bap10357/oct-pressure-device/pressure_encoder_documentation/figures/DRV8825_pinout.png

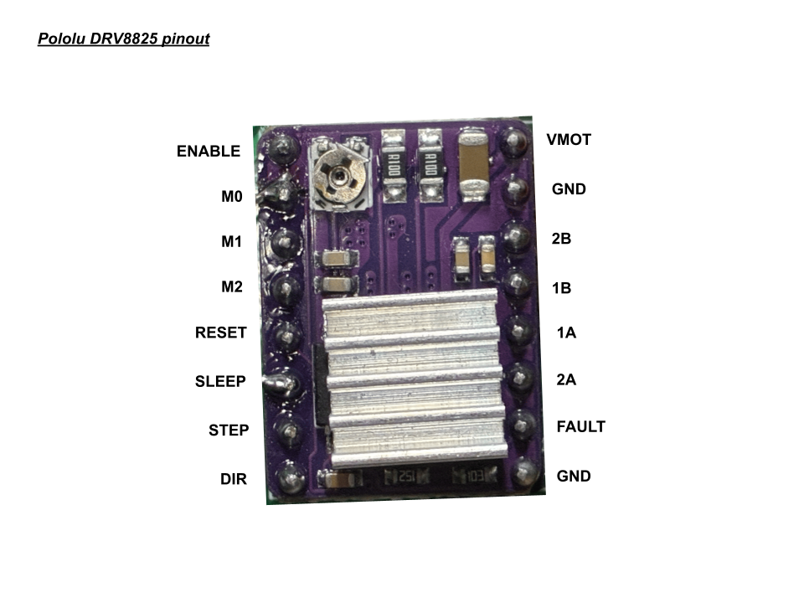
pressure_encoder_documentation/figures/DRV8825_pinout.png
