bap10357/oct-pressure-device/pressure_encoder_documentation/figures/completed_trial.png

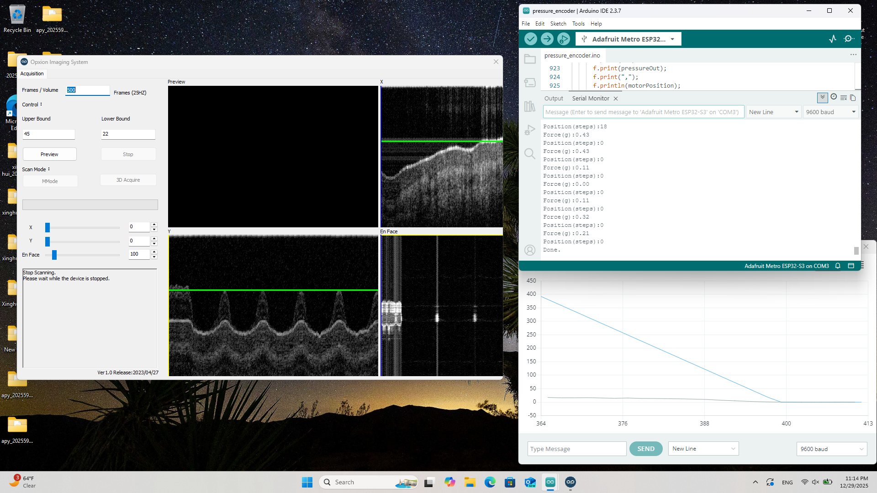
pressure_encoder_documentation/figures/completed_trial.png
