bap10357/oct-pressure-device/README.md

THIS REPOSITORY HAS BEEN MOVED TO CODEBERG --> https://codeberg.org/brpe/au-oct-pressure-device/

The source code, schematics, and documentation for the optical coherence tomography air pressure control device for the Asia University Biodesign Lab (https://pweb.asia.edu.tw/cwlung/).
