bap10357/oct-pressure-device/pressure_encoder_documentation/youtube.md

## How to use OCT pressure device
https://www.youtube.com/watch?v=-lr18eq3X60
