bap10357/oct-pressure-device/pressure_encoder_board/3D_view.png

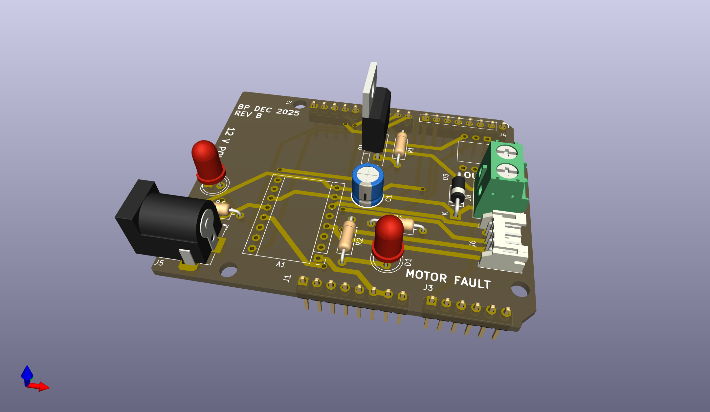
pressure_encoder_board/3D_view.png
