bap10357/oct-pressure-device/pressure_encoder_documentation/figures/airflow_diagram.png

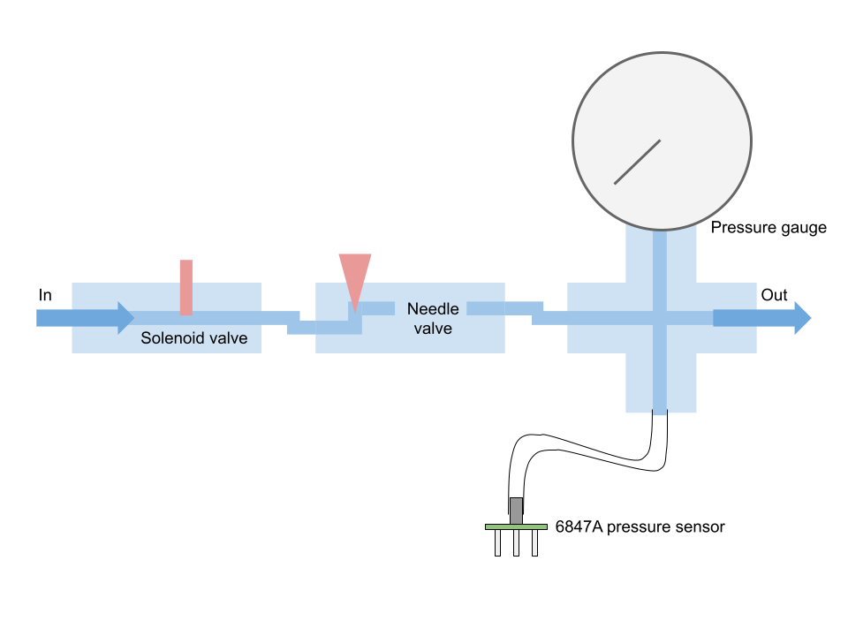
pressure_encoder_documentation/figures/airflow_diagram.png
