bap10357/oct-pressure-device/pressure_encoder_documentation/figures/connect_laser.png

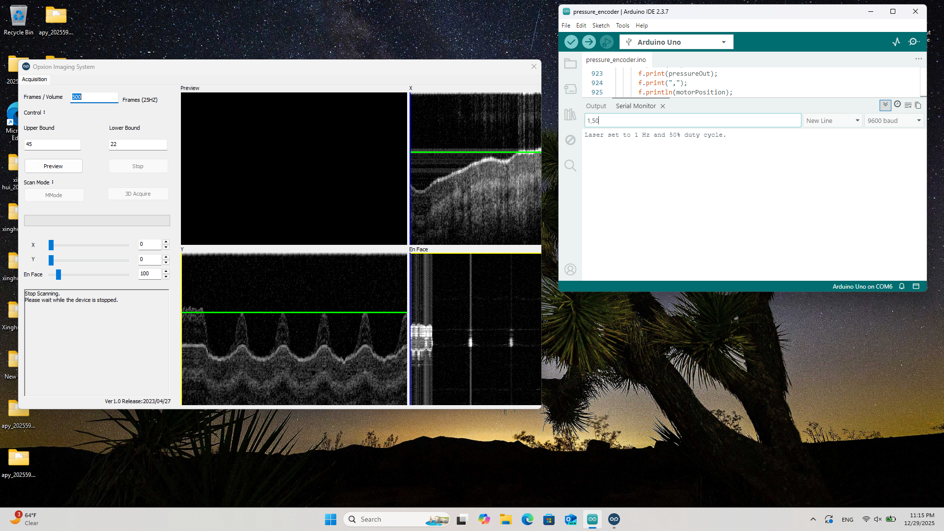
pressure_encoder_documentation/figures/connect_laser.png
