bap10357/oct-pressure-device/pressure_encoder_documentation/figures/processing_done.png

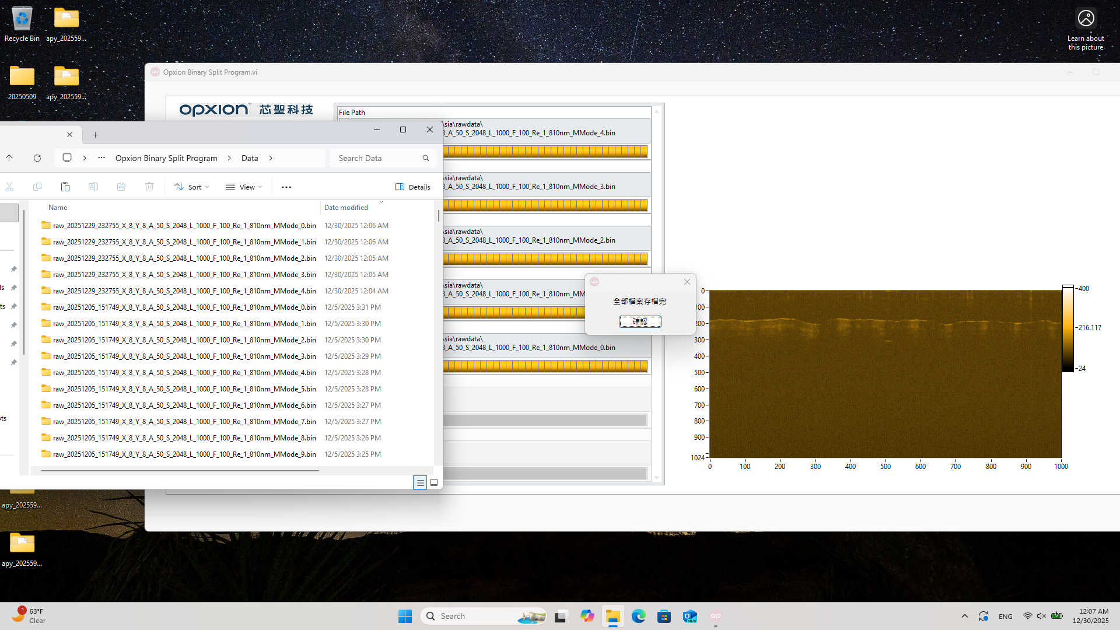
pressure_encoder_documentation/figures/processing_done.png
