bap10357/oct-pressure-device/pressure_encoder_board/pressure_encoder_board.kicad_pcb

## KiCad design pressure_encoder_board/pressure_encoder_board.kicad_pcb (2025-12-28)

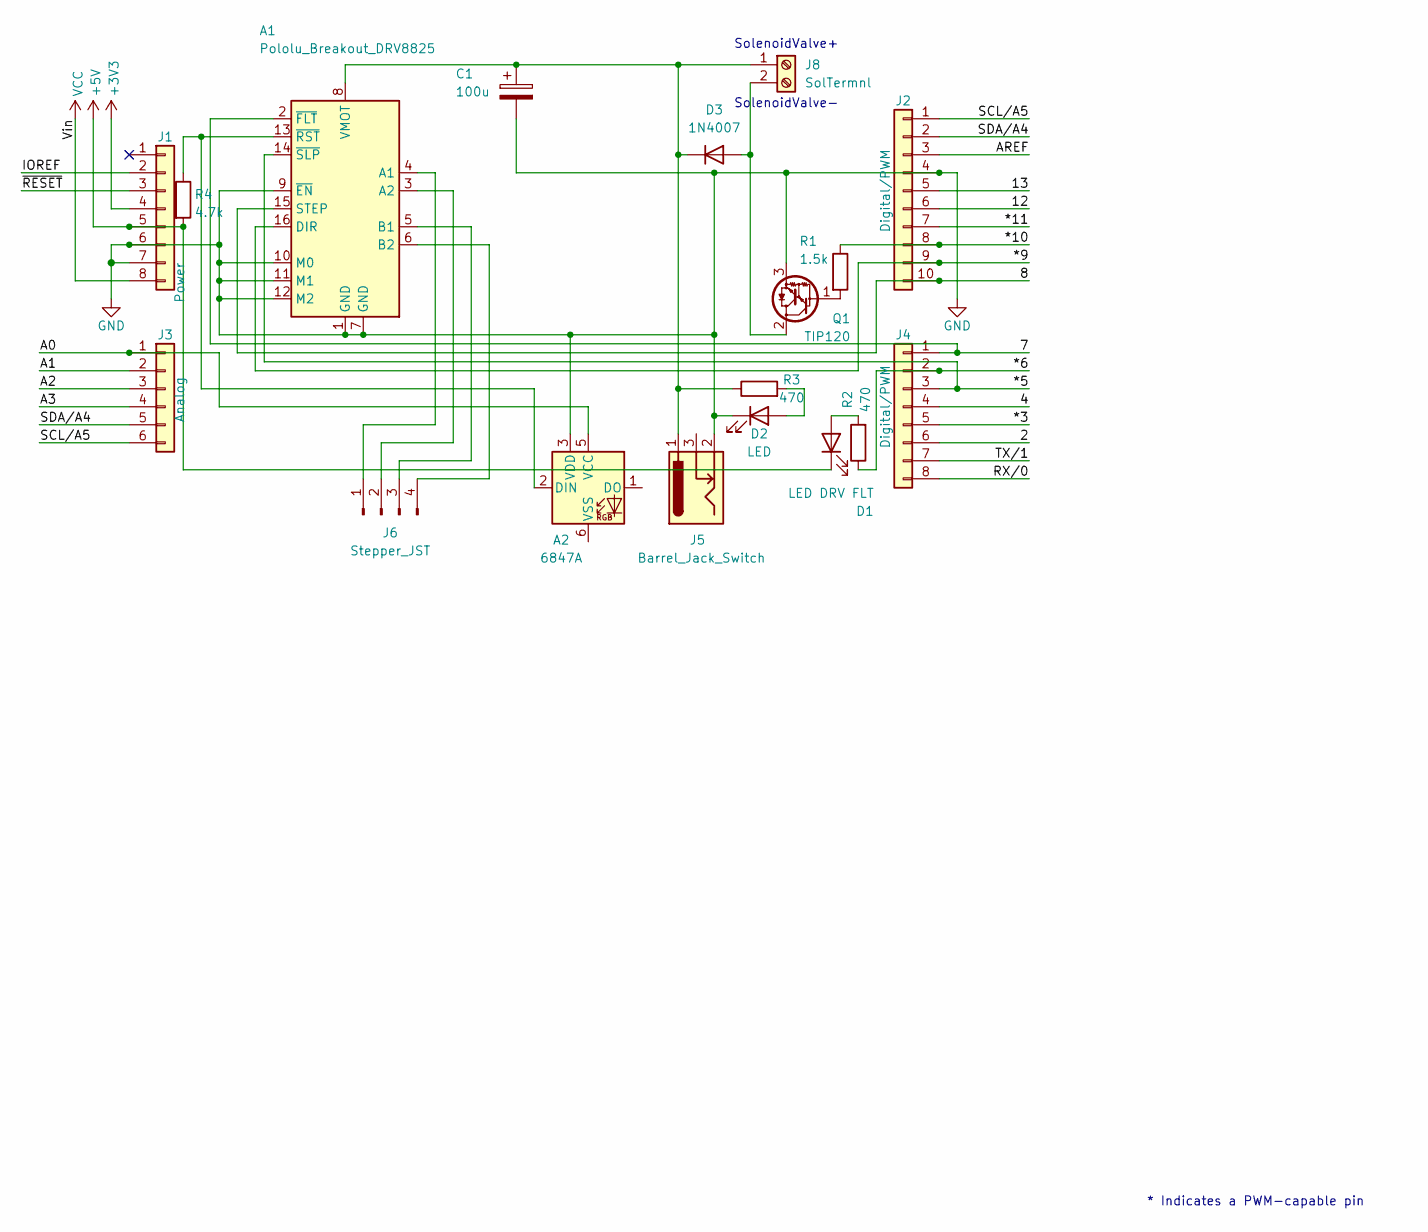
[picture p70: schematic pressure_encoder_board.kicad_sch, Arduino Hat for Pressure Controller]

Parts:
A1: Pololu_Breakout_DRV8825; Pololu_Breakout-16_15.2x20.3mm
A2: 6847A; DIP-6_W10.16mm
C1: 100u; CP_Radial_D6.3mm_P2.50mm
D1: LED DRV FLT; LED_D5.0mm
D2: LED; LED_D5.0mm
D3: 1N4007; D_DO-41_SOD81_P10.16mm_Horizontal
J1: Power; PinHeader_1x08_P2.54mm_Vertical
J2: Digital/PWM; PinHeader_1x10_P2.54mm_Vertical
J3: Analog; PinHeader_1x06_P2.54mm_Vertical
J4: Digital/PWM; PinHeader_1x08_P2.54mm_Vertical_Flipped_Trimmed
J5: Barrel_Jack_Switch; BarrelJack_Horizontal_Trimmed
J6: Stepper_JST; JST_PH_S4B-PH-K_1x04_P2.00mm_Horizontal
J8: SolTermnl; TerminalBlock_Phoenix_PT-1,5-2-5.0-H_1x02_P5.00mm_Horizontal
Q1: TIP120; TO-220-3_Vertical
R1: 1.5k; R_Axial_DIN0207_L6.3mm_D2.5mm_P10.16mm_Horizontal
R2, R3: 470; R_Axial_DIN0207_L6.3mm_D2.5mm_P10.16mm_Horizontal
R4: 4.7k; R_Axial_DIN0207_L6.3mm_D2.5mm_P10.16mm_Horizontal

Connections:
+3V3: J1.4
+5V: D1.1 (K), J1.5, R4.2
/2: J4.6
/4: J4.4
/7: A1.2 (~FLT), J4.1
/8: A1.15 (STEP), J2.10
/12: J2.6
/13: J2.5
/*3: J4.5
/*5: A1.14 (~SLP), J4.3
/*6: J4.2, R2.1
/*9: A1.16 (DIR), J2.9
/*10: J2.8, R1.1
/*11: J2.7
/A0: A2.5 (VCC), J3.1
/A1: J3.2
/A2: J3.3
/A3: J3.4
/AREF: J2.3
/IOREF: J1.2
/RX/0: J4.8
/SCL/A5: J2.1, J3.6
/SDA/A4: J2.2, J3.5
/TX/1: J4.7
/~RESET: J1.3
GND: A1.1 (GND), A1.7 (GND), A1.9 (~EN), A1.10 (M0), A1.11 (M1), A1.12 (M2), A2.3 (VDD), C1.2, D2.1 (K), J1.6, J1.7, J2.4, J5.2, Q1.3 (E)
unnamed: A1.4 (A1), J6.1
unnamed: A1.3 (A2), J6.2
unnamed: A1.5 (B1), J6.3
unnamed: A1.6 (B2), J6.4
unnamed: A1.8 (VMOT), C1.1, D3.1 (K), J5.1, J8.1, R3.1
unnamed: A1.13 (~RST), A2.2 (DIN), R4.1
unnamed: D1.2 (A), R2.2
unnamed: D2.2 (A), R3.2
unnamed: D3.2 (A), J8.2, Q1.2 (C)
unnamed: Q1.1 (B), R1.2
VCC: J1.8

Notes on the sheet:
SolenoidValve-
* Indicates a PWM-capable pin
SolenoidValve+

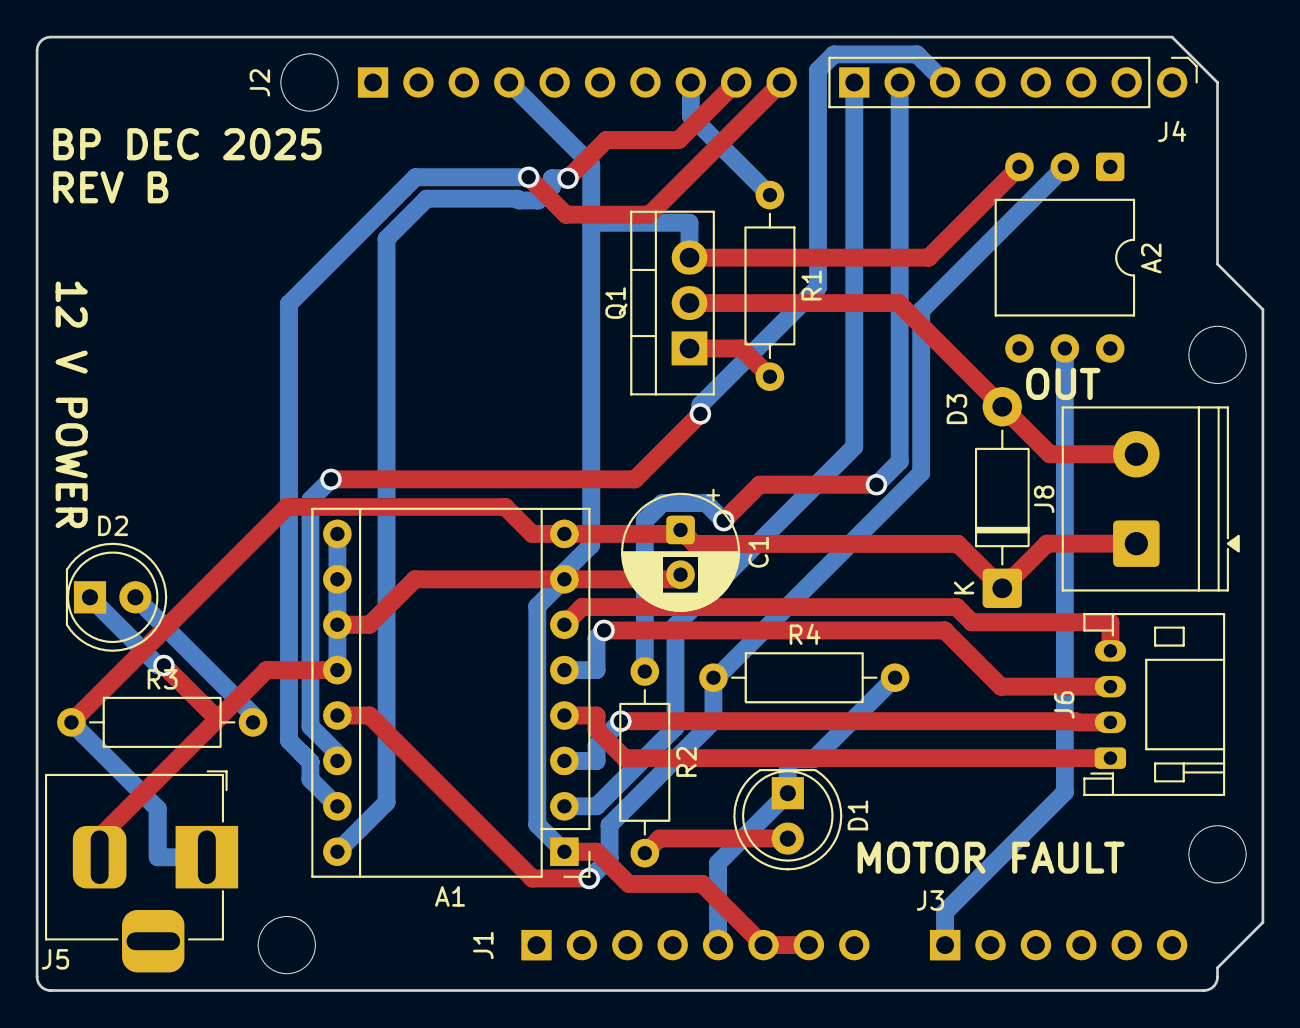
[picture p71: board pressure_encoder_board.kicad_pcb from above]

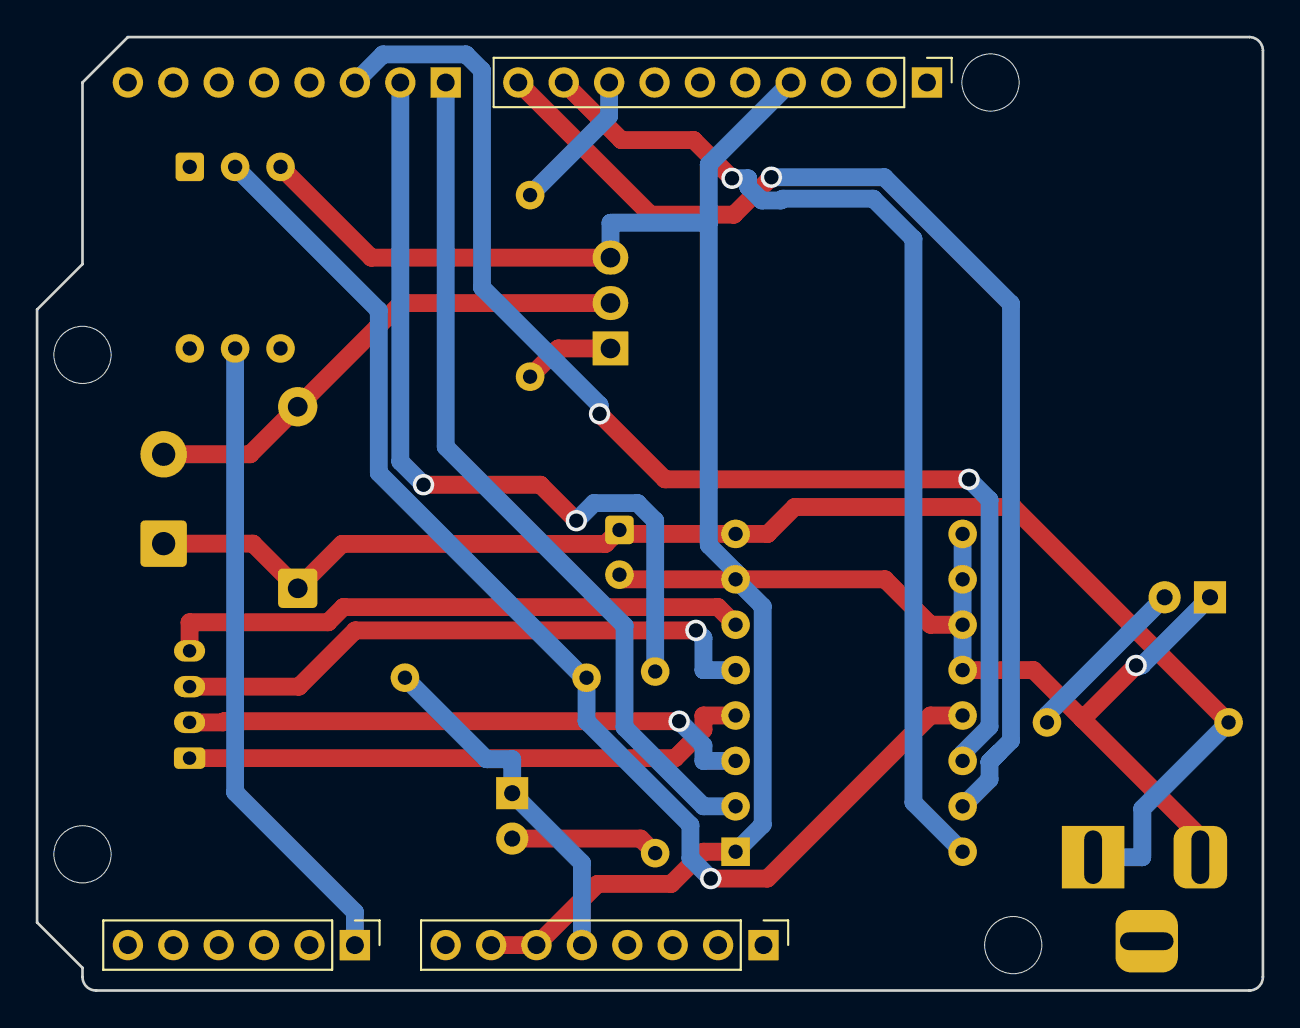
[picture p72: board pressure_encoder_board.kicad_pcb from below]

Board: 2 copper layers, 68.6 x 53.3 mm, 22 parts (4 on the bottom side), 21 nets.

Other parts of the board:
MH1, MH2, MH3, MH4: MountingHole_3.2mm
