bap10357/oct-pressure-device/(commit log)

2025-12-28 Change reference to /calibration.csv -> /sys/calibration.csv at end of calibration process
2025-12-30 Add note about manual valve reset
2026-01-01 Fix 11 -> 1 Hz typo in pilot study, change purchase -> manufacturing company for valves
    [pressure_encoder.ino]
2026-01-05 Add BOM to pressure device report
2026-01-05 Updated Bill of Materials for APCD and LPC
2026-05-26 Update pressure_encoder.ino
    Fix program record times not aligning with program run times
    [pressure_encoder.ino]
